IdeaPropulsionSystems/OpenAutoclave/Photos/IMG_1680.JPG

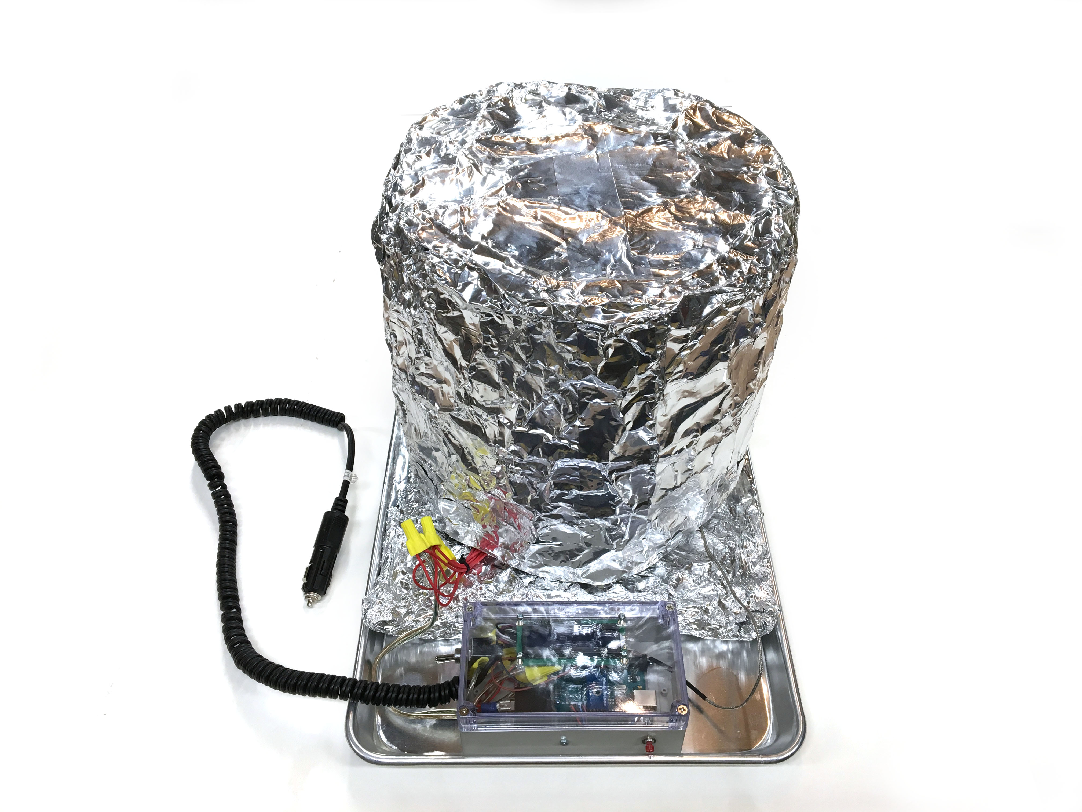
Photos/IMG_1680.JPG
