IdeaPropulsionSystems/OpenAutoclave/Photos/DavidAutoclave.jpg

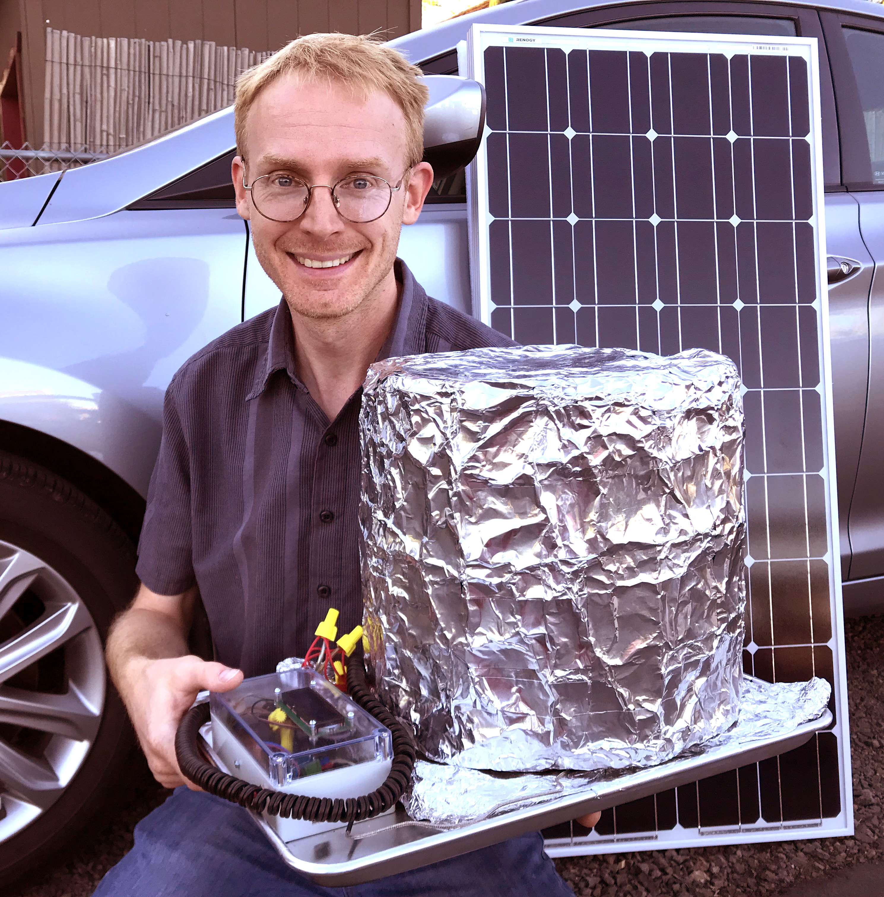
Photos/DavidAutoclave.jpg
