IdeaPropulsionSystems/OpenAutoclave/Notes/180923_DrillTemplate_boxLid.pdf

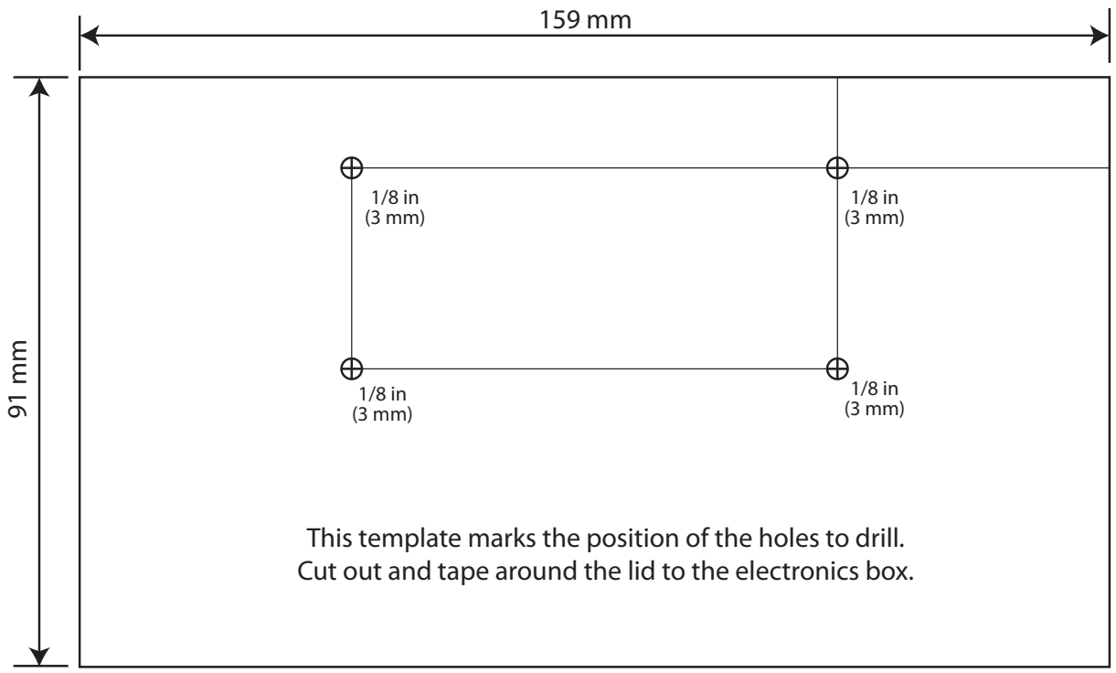
[picture p3: figure]

This template marks the position of the holes to drill. Cut out and tape around the lid to the electronics box.
