IdeaPropulsionSystems/OpenAutoclave/Photos/AutoclaveDone.jpg

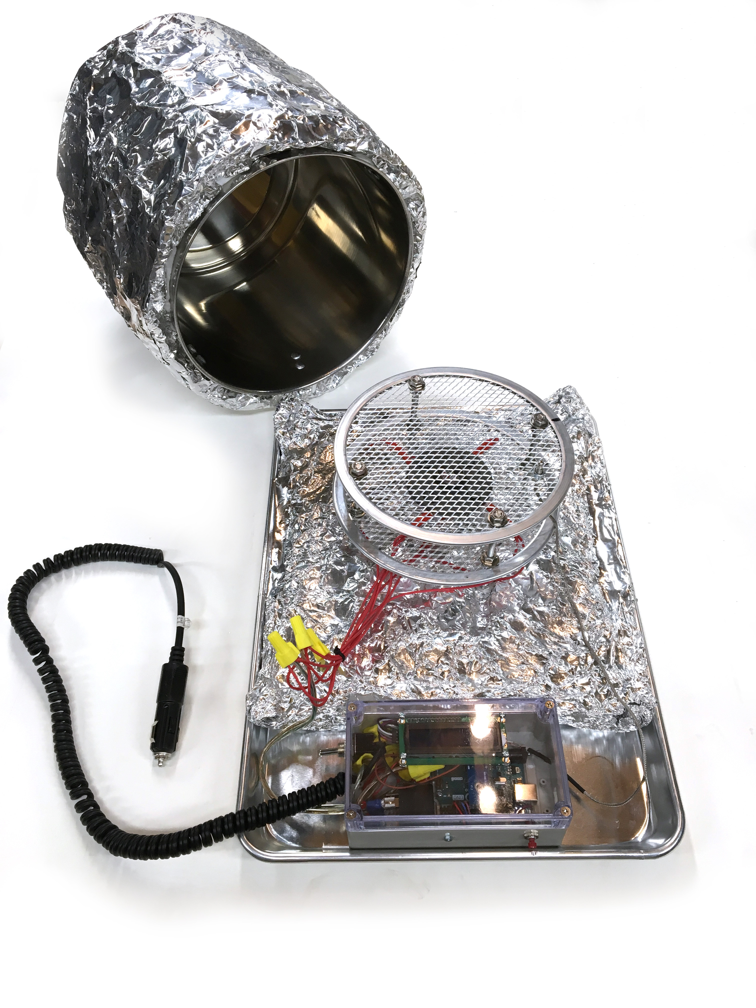
Photos/AutoclaveDone.jpg
