IdeaPropulsionSystems/OpenAutoclave/Notes/181016_AutoclaveSchematic.pdf

## Electronic Parts

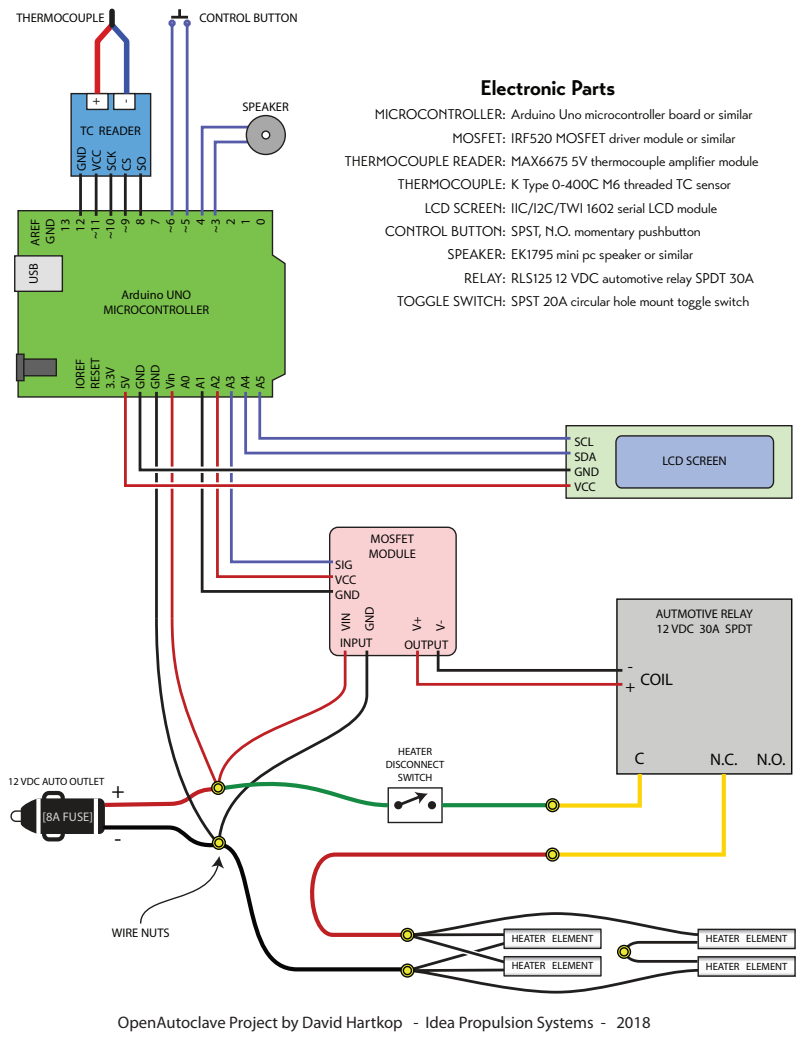
[picture p6: page 1]
AREF; GND 13; IOREF; RESET 3.3V 5V; GND; GND Vin A0; Arduino UNO MICROCONTROLLER; LCD SCREEN; SCL SDA GND VCC; SIG VCC GND; MOSFET MODULE; VIN; SPEAKER; THERMOCOUPLE; CONTROL BUTTON; USB; MICROCONTROLLER: MOSFET: THERMOCOUPLE READER: THERMOCOUPLE: LCD SCREEN: CONTROL BUTTON: SPEAKER:; TOGGLE SWITCH:; INPUT; OUTPUT; AUTMOTIVE RELAY 12 VDC 30A SPDT; COIL; HEATER ELEMENT; HEATER DISCONNECT; [8A FUSE]; WIRE NUTS

TC READER GND VCC SCK CSSO

Arduino Uno microcontroller board or similar
IRF520 MOSFET driver module or similar
MAX6675 5V thermocouple amplier module
K Type 0-400C M6 threaded TC sensor
IIC/I2C/TWI 1602 serial LCD module
SPST, N.O. momentary pushbuon
EK1795 mini pc speaker or similar
RELAY:
RLS125 12 VDC automotive relay SPDT 30A
SPST 20A circular hole mount toggle switch

SWITCH 12 VDC AUTO OUTLET

OpenAutoclave Project by David Hartkop - Idea Propulsion Systems - 2018
