IdeaPropulsionSystems/OpenAutoclave/Notes/181013_ElectronicsBoxLayout.pdf

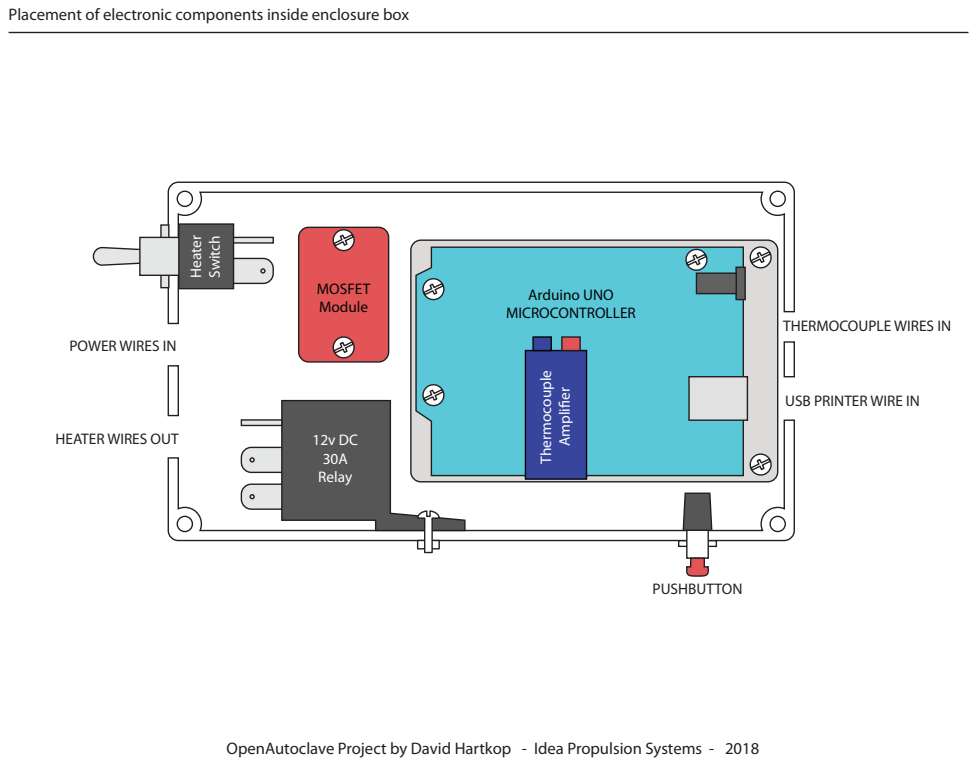
[picture p7: page 1]
Arduino UNO MICROCONTROLLER; MOSFET Module; 12v DC 30A Relay; Thermocouple Amplier; Heater Switch; PUSHBUTTON

Placement of electronic components inside enclosure box

THERMOCOUPLE WIRES IN

POWER WIRES IN

USB PRINTER WIRE IN

HEATER WIRES OUT

OpenAutoclave Project by David Hartkop - Idea Propulsion Systems - 2018
