IdeaPropulsionSystems/OpenAutoclave/Notes/180923_boxDrillTemplate.pdf

159 mm

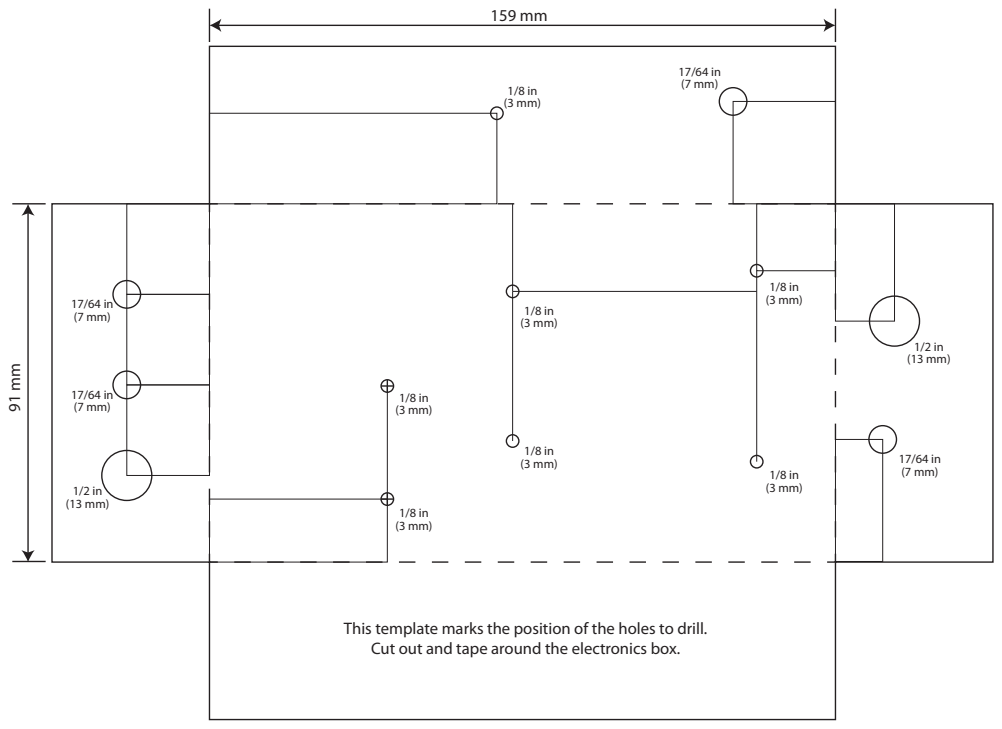
[picture p8: page 1]
Bottom; Back; Right; Left

This template marks the position of the holes to drill.
Cut out and tape around the electronics box.
