IdeaPropulsionSystems/OpenAutoclave/Notes/180723_AutoclaveSection.pdf

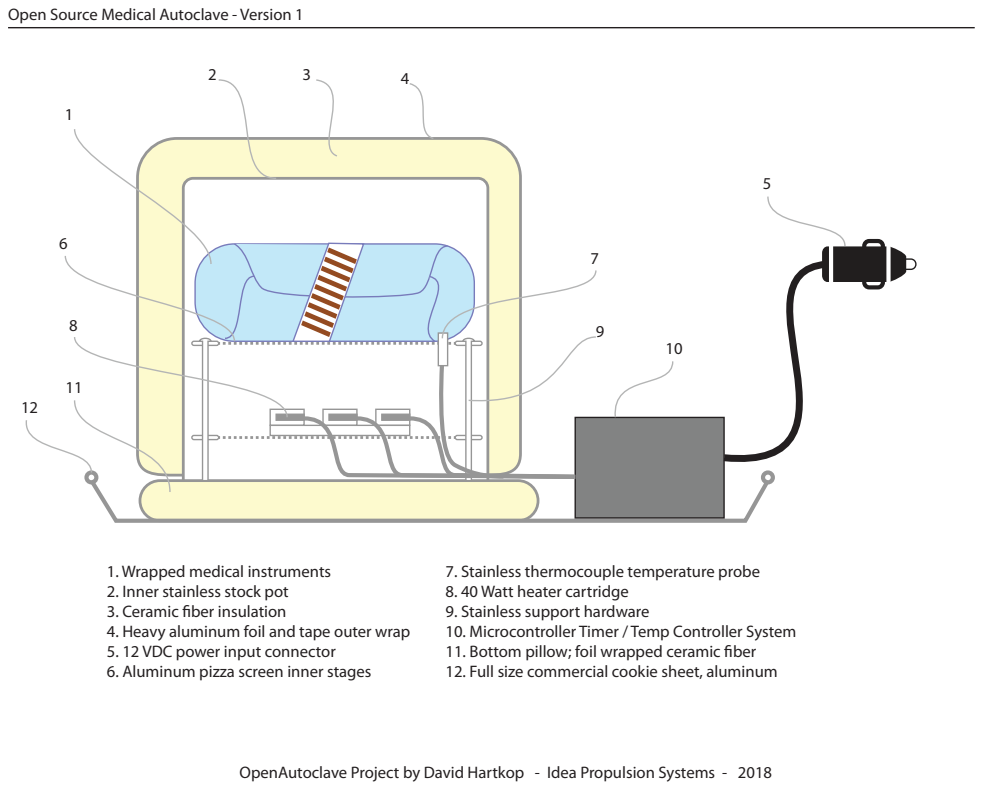
[picture p9: page 1]

Open Source Medical Autoclave - Version 1

1. Wrapped medical instruments
2. Inner stainless stock pot
3. Ceramic ber insulation
4. Heavy aluminum foil and tape outer wrap
5. 12 VDC power input connector
6. Aluminum pizza screen inner stages

7. Stainless thermocouple temperature probe
8. 40 Watt heater cartridge
9. Stainless support hardware
10. Microcontroller Timer / Temp Controller System
11. Bottom pillow; foil wrapped ceramic ber
12. Full size commercial cookie sheet, aluminum

OpenAutoclave Project by David Hartkop - Idea Propulsion Systems - 2018
