IdeaPropulsionSystems/OpenAutoclave/Notes/181015_ExposureTimesChart.pdf

Autoclave Exposure Temperature ˚C ˚F | Estimated Warmup Time (min. from 20˚C) | Recommended Exposure Time (minutes) | Total Cycle Time from Cold Start (minutes)

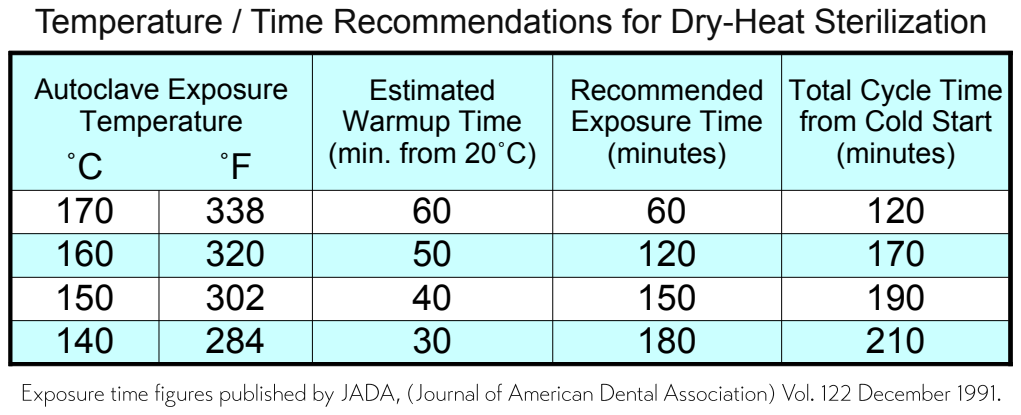
[picture p10: page 1]

Temperature / Time Recommendations for Dry-Heat Sterilization

170 | 338 | 60 | 60 | 120
160 | 320 | 50 | 120 | 170
150 | 302 | 40 | 150 | 190
140 | 284 | 30 | 180 | 210
