IdeaPropulsionSystems/OpenAutoclave/AutoclaveLogsheets/OpenAutoclave_ManualLogBook.pdf

Date:______
Cycle of the day #:______
Temp Goal of _____ reached at time:______ Completion time for exposure:______ Heater Off at:______

Date:______
Cycle of the day #:______
Temp Goal of _____ reached at time:______ Completion time exposure:______
Heater Off at:______

Date:______
Cycle of the day #:______
Temp Goal of _____ reached at time:______ Completion time for exposure:______ Heater Off at:______

Date:______
Cycle of the day #:______
Temp Goal of _____ reached at time:______ Completion time for exposure:______ Heater Off at:______

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

Date:______
Cycle of the day #:______
Temp Goal of _____ reached at time:______ Completion time for exposure:______ Heater Off at:______
Autoclave Exposure Temperature ˚C ˚F | Estimated Warmup Time (min. from 20˚C) | Recommended Exposure Time (minutes) | Total Cycle Time from Cold Start (minutes)
170 | 338 | 60 | 60 | 120
160 | 320 | 50 | 120 | 170
150 | 302 | 40 | 150 | 190
140 | 284 | 30 | 180 | 210

Temperature / Time Recommendations for Dry-Heat Sterilization

Exposure time figures published by JADA, (Journal of American Dental Association) Vol. 122 December 1991.

## OpenAutoclave Manual Operator’s Log Book
