IdeaPropulsionSystems/OpenAutoclave/(commit log)

2018-10-02 Added Arduino Sketch
2018-10-02 Added Autoclave Logsheets
    [OpenAutoclave_LogSheet.ods, OpenAutoclave_LogSheet.xls]
2018-10-17 Updating OpenAutoclave Resources
    [180901_autoclave_partslist.ods, OpenAutoclave_DataLogSheet.ods, OpenAutoclave_DataLogSheet.xls]
2018-10-20 Updated Arduino Sketch
2018-11-01 Update to Arduino Files
    Halloween update, new photos of OpenAutoclave, corrections to schematic
    labels
    [_181031_OpenAutoclave.ino]
