IdeaPropulsionSystems/OpenAutoclave/Photos/IMG_0607.JPG

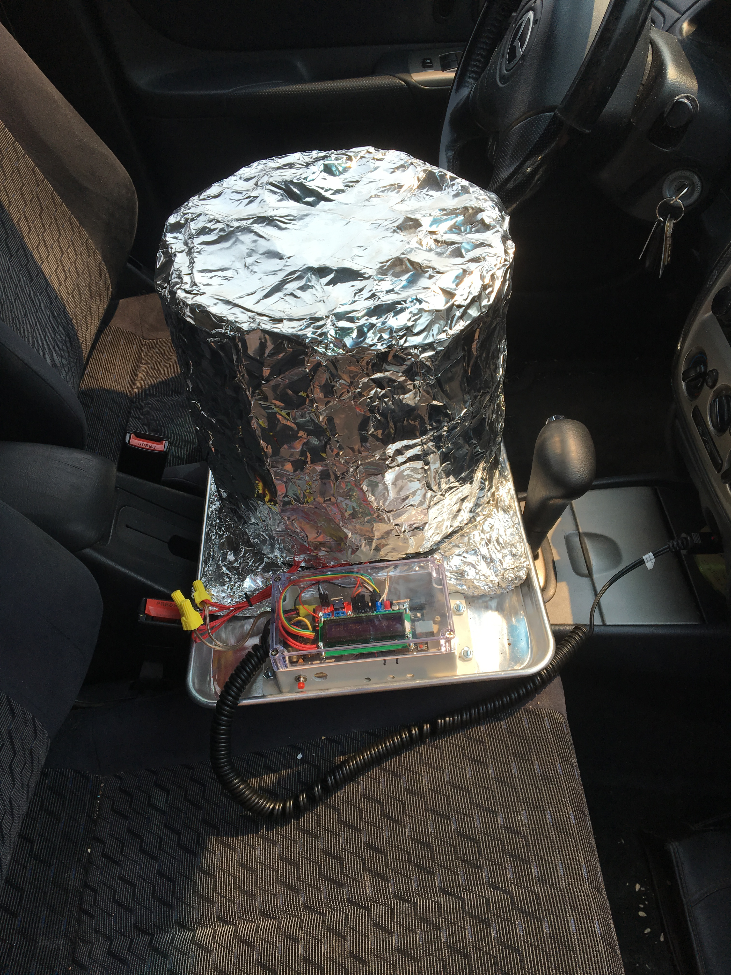
Photos/IMG_0607.JPG
